restep-eco/Restep/Mother Module/Restep Boost Design Equations.pdf

# Restep Boost Converter Design Calculations www.restep.eco

# Chris Arntzen 1/19/18, edited 12/19/20

# These design calculations and the nomenclature follow the TI LM5022-Q1 Detailed Design

Procedure. Items with orange background are actual selected components and values.

This work is licensed under a Creative Commons Attribution-ShareAlike 4.0 International License.

# Boost Converter Calculations: 48V 120W using LM5022-Q1 Controller____________________

Vin_min≔10.5 | ≔ Vin_max | 25 | ≔ Iout | 2.5 | ≔η | 0.9 | ≔ Vd | 0.5

# Output Voltage Setting_________________________________________________________

Vfb_min≔1.225 | ≔ Vfb_max | 1.275 | ≔ Vdiv_ratio | ――= 1.25
48

0.026

tolR≔0.001 | ≔ TCR | 25 | ≔ Trange | 60
RFB1≔1.3 10 ⋅ | 3 | RFB1_min≔RFB1 ⋅ ⎛

## ⎝1-tolR⎞

⎠-⎛

⎝RFB1 ⋅TCR⋅ 10 ⋅ | = ⁻⁶ Trange⎞
⎠ 1.297 10 ⋅ | 3

RFB1_max≔RFB1 ⋅ ⎛

## ⎝1+tolR⎞

⎠+⎛

⎝RFB1 ⋅TCR⋅ 10 ⋅ | = ⁻⁶ Trange⎞
⎠ 1.303 10 ⋅ | 3
RFB2≔48.7 10 ⋅ | 3 | RFB2_min≔RFB2 ⋅ ⎛ ⎝1-tolR⎞

⎠-⎛

⎝RFB2 ⋅TCR⋅ 10 ⋅ | = ⁻⁶ Trange⎞
⎠ 4.858 10 ⋅ | 4

RFB2_max≔RFB2 ⋅ ⎛

## ⎝1+tolR⎞

⎠+⎛

⎝RFB2 ⋅TCR⋅ 10 ⋅ | = ⁻⁶ Trange⎞
⎠ 4.882 10 ⋅ | 4
Vout_min≔Vfb_min ⋅ | = ⎛
⎜
⎝

――――――― RFB1_max+RFB2_min

RFB1_max

⎞
⎟
⎠

46.887

Vout_max≔Vfb_max ⋅ | = ⎛
⎜
⎝

――――――― RFB1_min+RFB2_max

RFB1_min

⎞
⎟
⎠

49.278

Created with PTC Mathcad Express. See www.mathcad.com for more information.

# Switching Frequency___________________________________________________________

fs_nom ≔400 10 ⋅ | 3 | tolfosc≔.1375 | ≔ RT_calc | ―――――――=

⎛

⎝1 | ⋅ -8 10 ⋅ | -8 fs_nom⎞
⎠
f | ⋅ | ⋅ s_nom 5.77 10⁻¹¹
4.194 10 ⋅ | 4
RT≔42.2 10 ⋅ | 3 | RT_min≔RT ⋅ ⎛ ⎝1-tolR⎞

⎠-⎛

⎝RT ⋅TCR⋅ 10 ⋅ | = ⁻⁶ Trange⎞
⎠ 4.209 10 ⋅ | 4

RT_max≔RT ⋅ ⎛

## ⎝1+tolR⎞

⎠+⎛

⎝RT ⋅TCR⋅ 10 ⋅ | = ⁻⁶ Trange⎞
⎠ 4.231 10 ⋅ | 4
fs_min≔ | = ⎛
⎜
⎝
―――――1 ―――― 8 10 ⋅ | + ⁻⁸ 5.77 10 ⋅ | ⋅ ⁻¹¹ RT_max

⎞
⎟
⎠

⎛

## ⎝1-tolfosc⎞

⎠ 3.421 10 ⋅ | 5
fs_max≔ | = ⎛
⎜
⎝
―――――1 ―――― 8 10 ⋅ | + ⁻⁸ 5.77 10 ⋅ | ⋅ ⁻¹¹ RT_min

⎞
⎟
⎠

⎛

## ⎝1+tolfosc⎞

⎠ 4.534 10 ⋅ 5

# Power and Duty Cycle__________________________________________________________

Pout_min≔Vout_min ⋅ Iout=117.216 | ≔ Pout_max | Vout_max ⋅ Iout=123.195

Pin_min≔―――= Pout_min
η
130.24 | ≔ Pin_max | ―――= Pout_max
η

136.883

Iin_min≔―――= Pin_min

Vin_max

5.21 | ≔ Iin_max | ―――= Pin_max

Vin_min

13.036

## Dmin≔――――――――= ⎛

⎝Vout_min-Vin_max+Vd⎞
⎠

Vout_min+Vd

0.472 | ≔ Dmax | ――――――――= ⎛

⎝Vout_max-Vin_min+Vd⎞
⎠

Vout_max+Vd

0.789

# Inductor and Currents__________________________________________________________

Coilcraft SER2918H-153KL 15uH 10% DCR=2.86mΩ | Isat=21.9A Irms=28A
Lnom ≔15 10 ⋅ | -6 | tolL≔0.1 | ≔ Lmin | Lnom ⋅ ⎛

## ⎝1-tolL⎞

⎠=1.35 10 ⋅ | -5
Isat_rat≔21.9 | ≔ Irms_rat | 28 | ≔ Lmax | Lnom ⋅ ⎛

## ⎝1+tolL⎞

⎠=1.65 10 ⋅ | -5
ΔIL_min≔ | = ⎛
⎜
⎝

――― Vin_min

Lmax

⎞
⎟
⎠

⎛
⎜
⎝

## ――Dmax

fs_max

⎞
⎟
⎠
1.107 | ≔ ΔIL_max | = ⎛
⎜
⎝

――― Vin_max

Lmin

⎞
⎟
⎠

⎛
⎜
⎝

## ――Dmin

fs_min

⎞
⎟
⎠

2.557

ILrms_min≔ | =
Iin_min +² | ⎛
⎜
⎝

## ――― ΔIL_max

12

⎞
⎟
⎠

2
5.214 | ≔ ILrms_max | =
Iin_max +² | ⎛
⎜
⎝

## ――― ΔIL_min

12

⎞
⎟
⎠

2
13.037

ILpk_min≔Iin_min+―――= ΔIL_max

2

6.488 | ILpk_max≔Iin_max+―――= ΔIL_min

2

13.59

ILpk_op≔―――= ILpk_max

Isat_rat

0.621 | ≔ ILrms_op | ―――= ILrms_max

Irms_rat

0.466

## Kmin≔―――= ΔIL_min

ILrms_max

0.085 | ≔ Kmax | ―――= ΔIL_max

ILrms_min

0.49

# Output Capacitor and Output Voltage Ripple________________________________________

# Kemet C1812C335K1RAC7800 3.3uF X7R 1812 100V 10% 20% DC Bias Derating

tolC≔0.1 | ≔ DCbias | 0.2 | ≔ Qty | 3 | ≔ Cnom | 3.3 10 ⋅ | -6

Cout_min≔Qty C⋅ nom ⋅ ⎛

## ⎝1-tolC⎞

⎠ ⋅ ⎛

## ⎝1- DCbias⎞

⎠=7.128 10 ⋅ -6

Cout_max≔Qty C⋅ nom ⋅ ⎛

## ⎝1+tolC⎞

⎠ ⋅ ⎛

## ⎝1- DCbias⎞

⎠=8.712 10 ⋅ -6

ΔVout_max≔―――――= Dmax ⋅ Iout

f | ⋅ s_min Cout_min
0.809 | ≔ ΔVpercent | ――――= ΔVout_max

Vout_max

0.016

# Current Sense Resistor Calculations_______________________________________________

VCL_nom ≔0.5 | ≔ VCL_min | 0.434 | ≔ VCL_max | 0.55 | ≔ ILIM | 20

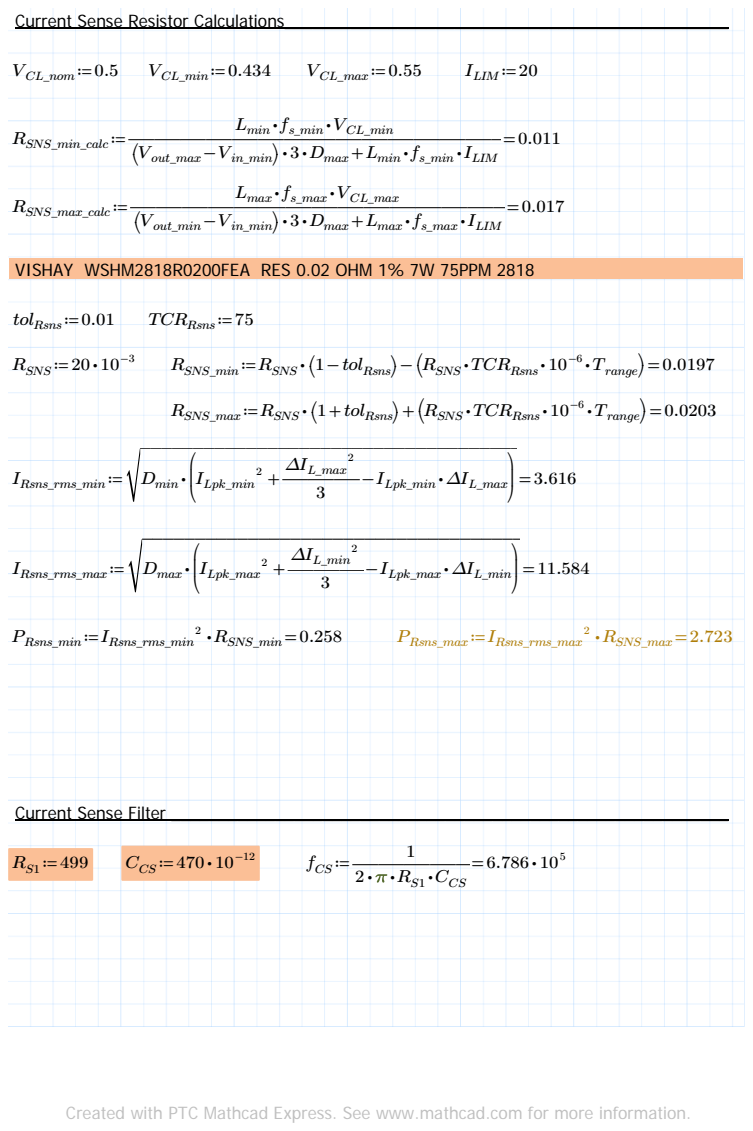
[picture p1: page 4]
RSNS_min_calc≔―――――――――――――――= Lmin ⋅ f; ⋅ s_min VCL_min; ⎝Vout_max-Vin_min⎞; ⎠ ⋅ 3 ⋅ Dmax+Lmin ⋅ f; ⋅ s_min ILIM; RSNS_max_calc≔―――――――――――――――= Lmax ⋅ f; ⋅ s_max VCL_max; ⎝Vout_min-Vin_min⎞; ⎠ ⋅ 3 ⋅ Dmax+Lmax ⋅ f; ⋅ s_max ILIM; tolRsns≔0.01; ≔ TCRRsns; RSNS≔20 10 ⋅; RSNS_min≔RSNS ⋅ ⎛; ⎝1-tolRsns⎞; ⎝RSNS ⋅TCRRsns ⋅ 10 ⋅; = ⁻⁶ Trange⎞; RSNS_max≔RSNS ⋅ ⎛; ⎝1+tolRsns⎞; IRsns_rms_min≔; Dmin ⋅; ILpk_min +; ――― ΔIL_max; ⋅ Lpk_min ΔIL_max; IRsns_rms_max≔; Dmax ⋅; ILpk_max +; ――― ΔIL_min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

VISHAY WSHM2818R0200FEA RES 0.02 OHM 1% 7W 75PPM 2818

Current Sense Filter ___________________________________________________________

# Slope Compensation Resistor_____________________________________________________

RS2_min_calc≔――――――――= VCL_min-I | ⋅ LIM RSNS_min
45 10 ⋅ | ⋅ ⁻⁶ Dmax
1.121 10 ⋅ | 3 | tolRS≔0.001
RS2_max_calc≔――――――――= VCL_max-I | ⋅ LIM RSNS_max
45 10 ⋅ | ⋅ ⁻⁶ Dmin
6.783 10 ⋅ | 3 | TCRRS≔25
RS2≔1.69 10 ⋅ | 3 | RS2_min≔RS2 ⋅ ⎛ ⎝1-tolRS⎞

⎠-⎛

⎝RS2 ⋅TCRRS ⋅ 10 ⋅ | = ⁻⁶ Trange⎞
⎠ 1.6858 10 ⋅ | 3

RS2_max≔RS2 ⋅ ⎛

## ⎝1+tolRS⎞

⎠+⎛

⎝RS2 ⋅TCRRS ⋅ 10 ⋅ | = ⁻⁶ Trange⎞
⎠ 1.6942 10 ⋅ | 3

RS1_min≔RS1 ⋅ ⎛

## ⎝1-tolRS⎞

⎠-⎛

⎝RS1 ⋅TCRRS ⋅ 10 ⋅ | = ⁻⁶ Trange⎞
⎠ 497.753

RS1_max≔RS1 ⋅ ⎛

## ⎝1+tolRS⎞

⎠+⎛

⎝RS1 ⋅TCRRS ⋅ 10 ⋅ | = ⁻⁶ Trange⎞
⎠ 500.248

# Current Limit Trip Point_________________________________________________________

ITRIP_min≔――――――――――――――――= VCL_min-45 10 ⋅ | ⋅ | ⋅ ⁻⁶ Dmax ⎛ ⎝RS2_max+RS1_max+2000⎞
⎠
| | RSNS_max

14.049

ITRIP_max≔――――――――――――――――= VCL_max-45 10 ⋅ | ⋅ | ⋅ ⁻⁶ Dmin ⎛ ⎝RS2_min+RS1_min+2000⎞
⎠
| | RSNS_min

23.392

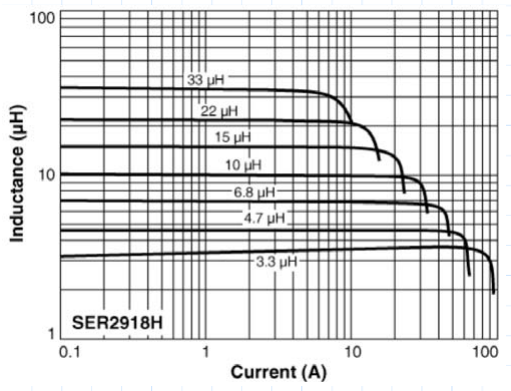
[picture p2: figure]

# Slope Compensation Comparison_________________________________________________

Sn_min≔――――――= R | ⋅ SNS_min Vin_min

Lmax

1.254 10 ⋅ | 4 | Sn_max≔――――――= R | ⋅ SNS_max Vin_max
| | | Lmin
3.757 10 ⋅ | 4
Se_min≔45 10 ⋅ | ⋅ | ⋅ | = ⁻⁶ fs_min ⎛
⎝RS1_min+RS2_min+2000⎞
⎠ 6.441 10 ⋅ | 4
Se_max≔45 10 ⋅ | ⋅ | ⋅ | = ⁻⁶ fs_max ⎛
⎝RS1_max+RS2_max+2000⎞

⎠ 8.558 10 ⋅ 4

# Want slope compensation ramp ratio of 1, or at least 0.5 (Se/Sn)

SCratio_min≔―――= Se_min

Sn_max

1.714 | ≔ SCratio_max | ―――= Se_max

Sn_min

6.823

# Loss Calculations______________________________________________________________

# VISHAY SQJA92EP-T1_GE3 MOSFET

RDS_ON_max≔0.0095 1.3 0.012 | ≔ ⋅ | = | tr | 10 10 ⋅ | -9 | tf≔25 10 ⋅ | -9 | Qg≔45 10 ⋅ | -9
ICC≔0.004 | ≔ IGC | Qg ⋅ fs_max=0.02 | PQ_max≔Vin_max ⋅ ⎛

⎝ICC +IGC⎞
⎠=0.61

PSW_max≔0.5 ⋅Vin_min ⋅ Iin_max ⋅ ⎛

## ⎝tr+tf

⎞

## ⎠ ⋅ fs_max=1.086

PCOND_max≔Dmax ⋅ Iin_max ⋅ | = ² RDS_ON_max | 1.656

PFET_max≔PSW_max+PCOND_max=2.742

NOTE: the FET selected above failed during testing at full load and low line, likely due to operation outside of the FET SOA. The FET below is the chosen replacement and did not fail during testing.

# VISHAY SUM70060E MOSFET

RDS_ON_max≔0.0062 1.3 0.008 | ≔ ⋅ | = | tr | 44 10 ⋅ | -9 | tf≔18 10 ⋅ | -9 | Qg≔81 10 ⋅ | -9
ICC≔0.004 | ≔ IGC | Qg ⋅ fs_max=0.037 | PQ_max≔Vin_max ⋅ ⎛

⎝ICC +IGC⎞
⎠=1.018

PSW_max≔0.5 ⋅Vin_min ⋅ Iin_max ⋅ ⎛

## ⎝tr+tf

⎞

## ⎠ ⋅ fs_max=1.924

PCOND_max≔Dmax ⋅ Iin_max ⋅ | = ² RDS_ON_max | 1.081

PFET_max≔PSW_max+PCOND_max=3.005

# Diodes Inc. SDT5H100P5-7 Schottky Rectifier

## PD_max≔Vd ⋅ Iout=1.25

# Inductor losses estimated by Coilcraft online loss calculator @ 50degC, max Iin & fs

PL_max≔0.554 | Almost all loss is due to winding DCR

PLOSS_max≔PL_max+PD_max+PFET_max+PQ_max+PRsns_max=8.549

ηest≔―――――――= Pout_max

Pout_max+PLOSS_max

0.935

# Under Voltage Lock Out_________________________________________________________

VSD_min≔1.22 | ≔ VSD_max | 1.28 | ≔ tolRuv | 0.01 | ≔ TCRRuv | 100
RUVbot≔1.47 10 ⋅ | 3 | RUVtop≔10 10 ⋅ | 3

RUVbot_min≔RUVbot⋅ ⎛

## ⎝1-tolRuv⎞

⎠-⎛

⎝RUVbot⋅TCRRuv ⋅ 10 ⋅ | = ⁻⁶ Trange⎞
⎠ 1.446 10 ⋅ | 3

RUVbot_max≔RUVbot⋅ ⎛

## ⎝1+tolRuv⎞

⎠+⎛

⎝RUVbot⋅TCRRuv ⋅ 10 ⋅ | = ⁻⁶ Trange⎞
⎠ 1.494 10 ⋅ | 3

RUVtop_min≔RUVtop ⋅ ⎛

## ⎝1-tolRuv⎞

⎠-⎛

⎝RUVtop ⋅TCRRuv ⋅ 10 ⋅ | = ⁻⁶ Trange⎞
⎠ 9.84 10 ⋅ | 3

RUVtop_max≔RUVtop ⋅ ⎛

## ⎝1+tolRuv⎞

⎠+⎛

⎝RUVtop ⋅TCRRuv ⋅ 10 ⋅ | = ⁻⁶ Trange⎞
⎠ 1.016 10 ⋅ | 4
VUVLO_min≔VSD_min ⋅ | = ⎛
⎜
⎝

―――――――― RUVbot_max+RUVtop_min

RUVbot_max

⎞
⎟
⎠

9.258

VUVLO_max≔VSD_max ⋅ | = ⎛
⎜
⎝

―――――――― RUVbot_min+RUVtop_max

RUVbot_min

⎞
⎟
⎠

10.271

# Soft Start____________________________________________________________________

ISS_min≔7 10 ⋅ | -6 | ISS_max≔13 10 ⋅ | -6 | VSS_OFF_min≔0.344 | ≔ VSS_OFF_max | 0.75
CSS≔100 10 ⋅ | -9
CSS_min≔CSS ⋅ 0.9 0.85 | ⋅ ⋅ | =7.65 10⁻⁸
CSS_max≔CSS ⋅ 1.1 1.15 | ⋅ ⋅ | =1.265 10⁻⁷
tSS_min≔―――――――= V | | ⋅ SS_OFF_min CSS_min

ISS_max

0.002 | ≔ tSS_max | ―――――――= V | ⋅ SS_OFF_max CSS_max

ISS_min

0.014
