restep-eco/Restep/Restep Color Code Rev.B.pdf

## Restep Power System LED Color Code (Rev. B)

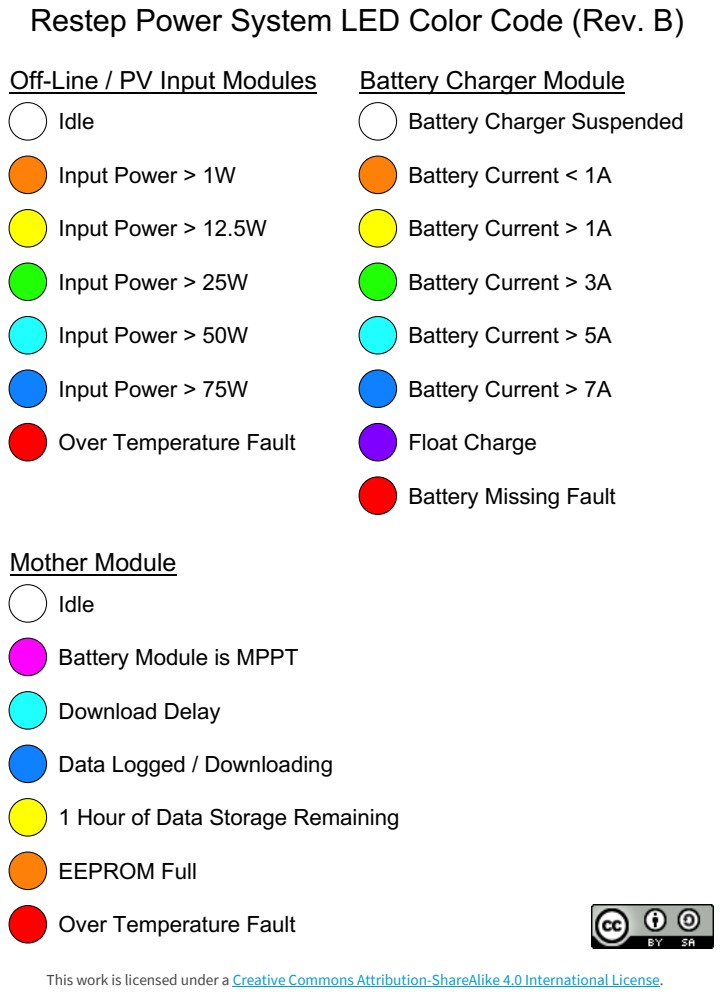
[picture p3: page 1]
Off-Line / PV Input Modules; Battery Charger Module; Idle; Battery Charger Suspended; Input Power > 1W; Battery Current < 1A; Input Power > 12.5W; Battery Current > 1A; Input Power > 25W; Battery Current > 3A; Input Power > 50W; Battery Current > 5A; Input Power > 75W; Battery Current > 7A; Over Temperature Fault; Float Charge; Mother Module; Download Delay; EEPROM Full

Battery Missing Fault

Battery Module is MPPT

Data Logged / Downloading

1 Hour of Data Storage Remaining

Over Temperature Fault

This work is licensed under a Creative Commons Attribution-ShareAlike 4.0 International License.
