restep-eco/Restep/Restep Block Diagram.pdf

# Restep Power System Simplified Block Diagram

This work is licensed under a Creative Commons Attribution-ShareAlike 4.0 International License. (https://creativecommons.org/licenses/by-sa/4.0/)

7/1/21 | www.restep.eco

# Current Architecture

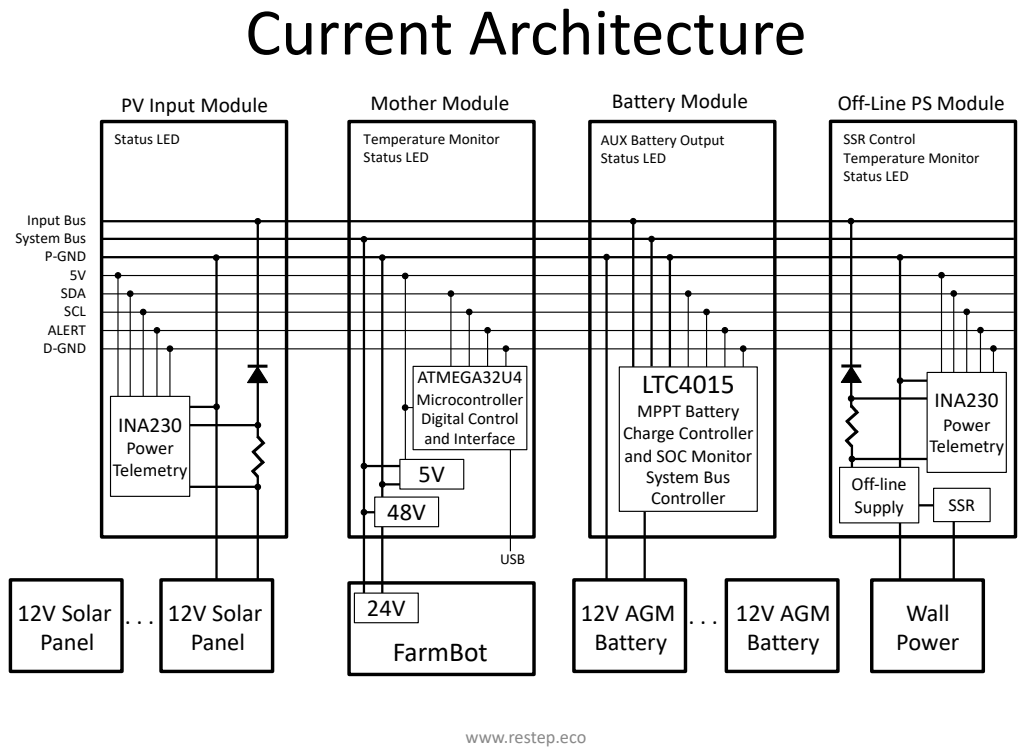
[picture p4: page 2]
Input Bus System Bus P-GND 5V SDA SCL ALERT D-GND; 12V Solar; Panel; FarmBot; USB; Status LED; Temperature Monitor; ATMEGA32U4 Microcontroller Digital Control and Interface; 12V Solar Panel; 12V AGM; Battery; 12V AGM Battery; SSR Control Temperature Monitor Status LED; Off-line Supply; Wall Power; SSR; INA230 Power Telemetry; PV Input Module; Mother Module; Battery Module; Off-Line PS Module

AUX Battery Output
Status LED

LTC4015
MPPT Battery
Charge Controller
and SOC Monitor
System Bus
Controller

www.restep.eco

# Architecture with UIM

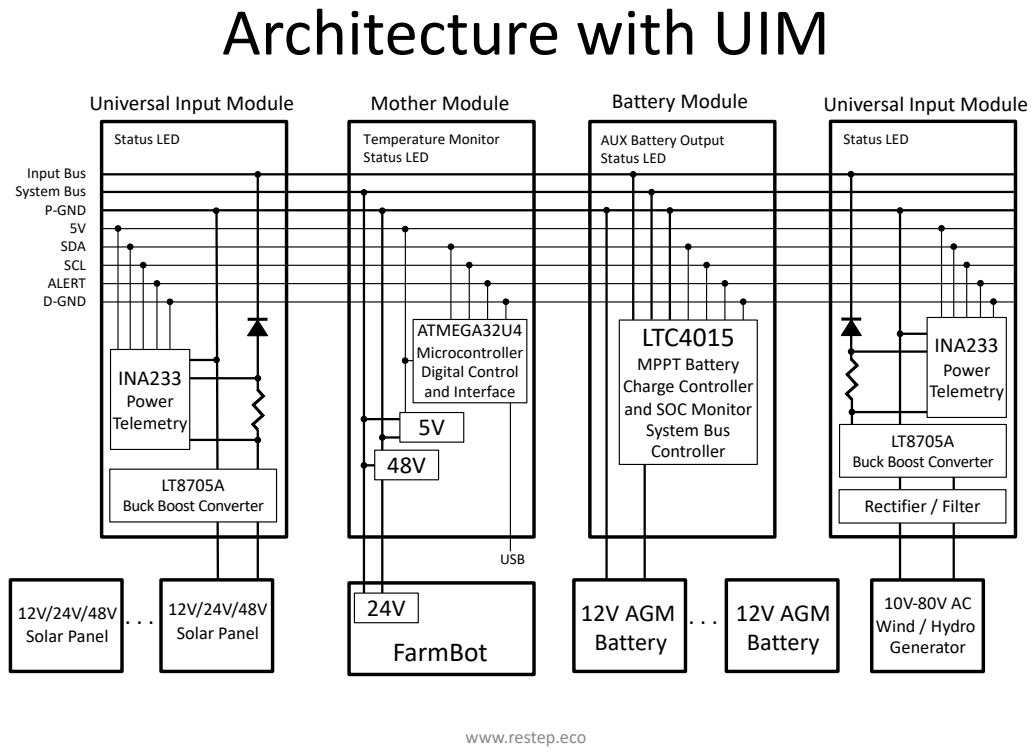
[picture p5: page 3]
Input Bus System Bus P-GND 5V SDA SCL ALERT D-GND; 12V/24V/48V Solar Panel; Status LED; Temperature Monitor; 12V AGM; Battery; 10V-80V AC Wind / Hydro Generator; INA233 Power Telemetry; Universal Input Module; Mother Module; Battery Module; Rectifier / Filter; 12V AGM Battery; USB; 24V FarmBot; ATMEGA32U4 Microcontroller Digital Control and Interface

Universal Input Module

AUX Battery Output
Status LED

LTC4015
MPPT Battery
Charge Controller
and SOC Monitor
System Bus
Controller

Buck Boost Converter

www.restep.eco
