restep-eco/Restep/Mother Module/RESTEP MOTHER MODULE SCHEMATIC.pdf

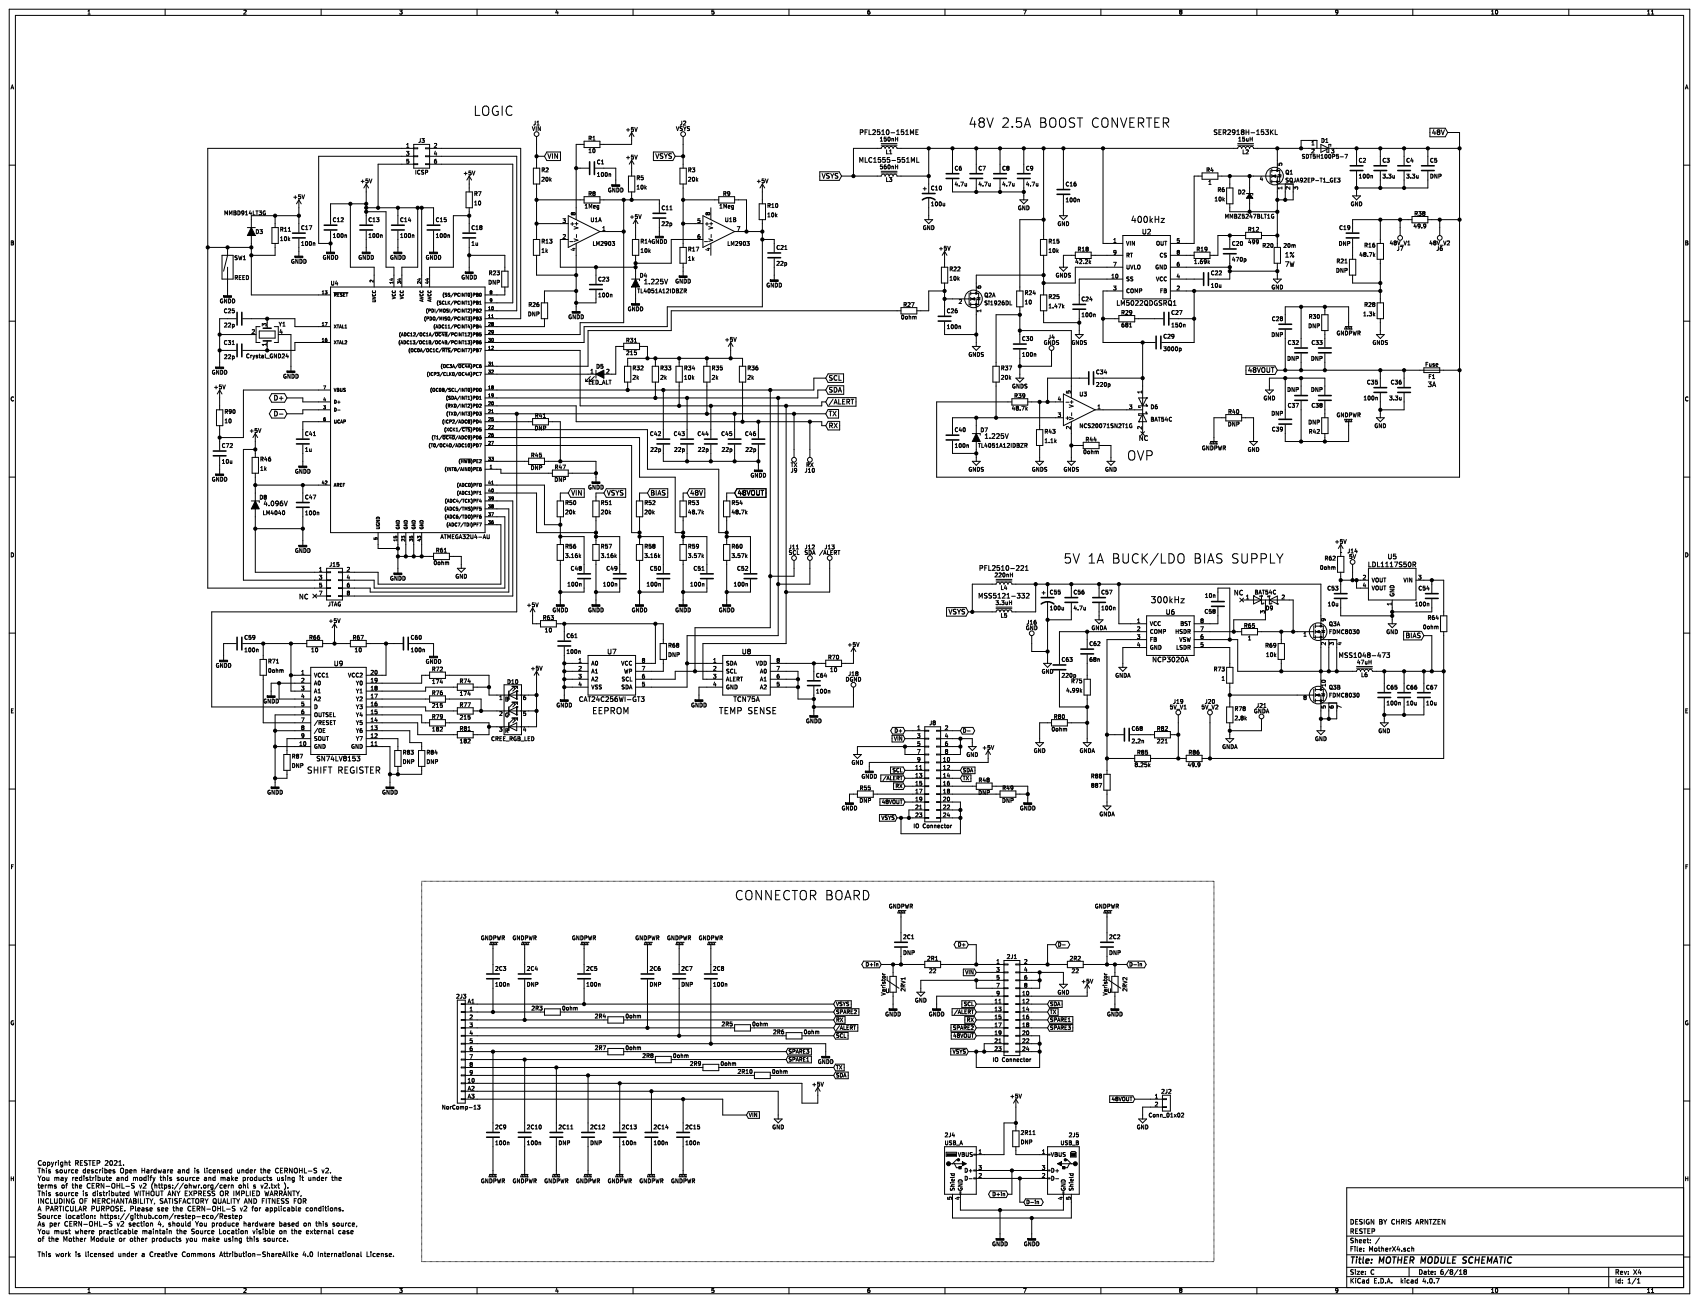
[picture p6: page 1]
