restep-eco/Restep/Off-Line Module/RESTEP OFF-LINE PV MODULE SCHEMATIC.pdf

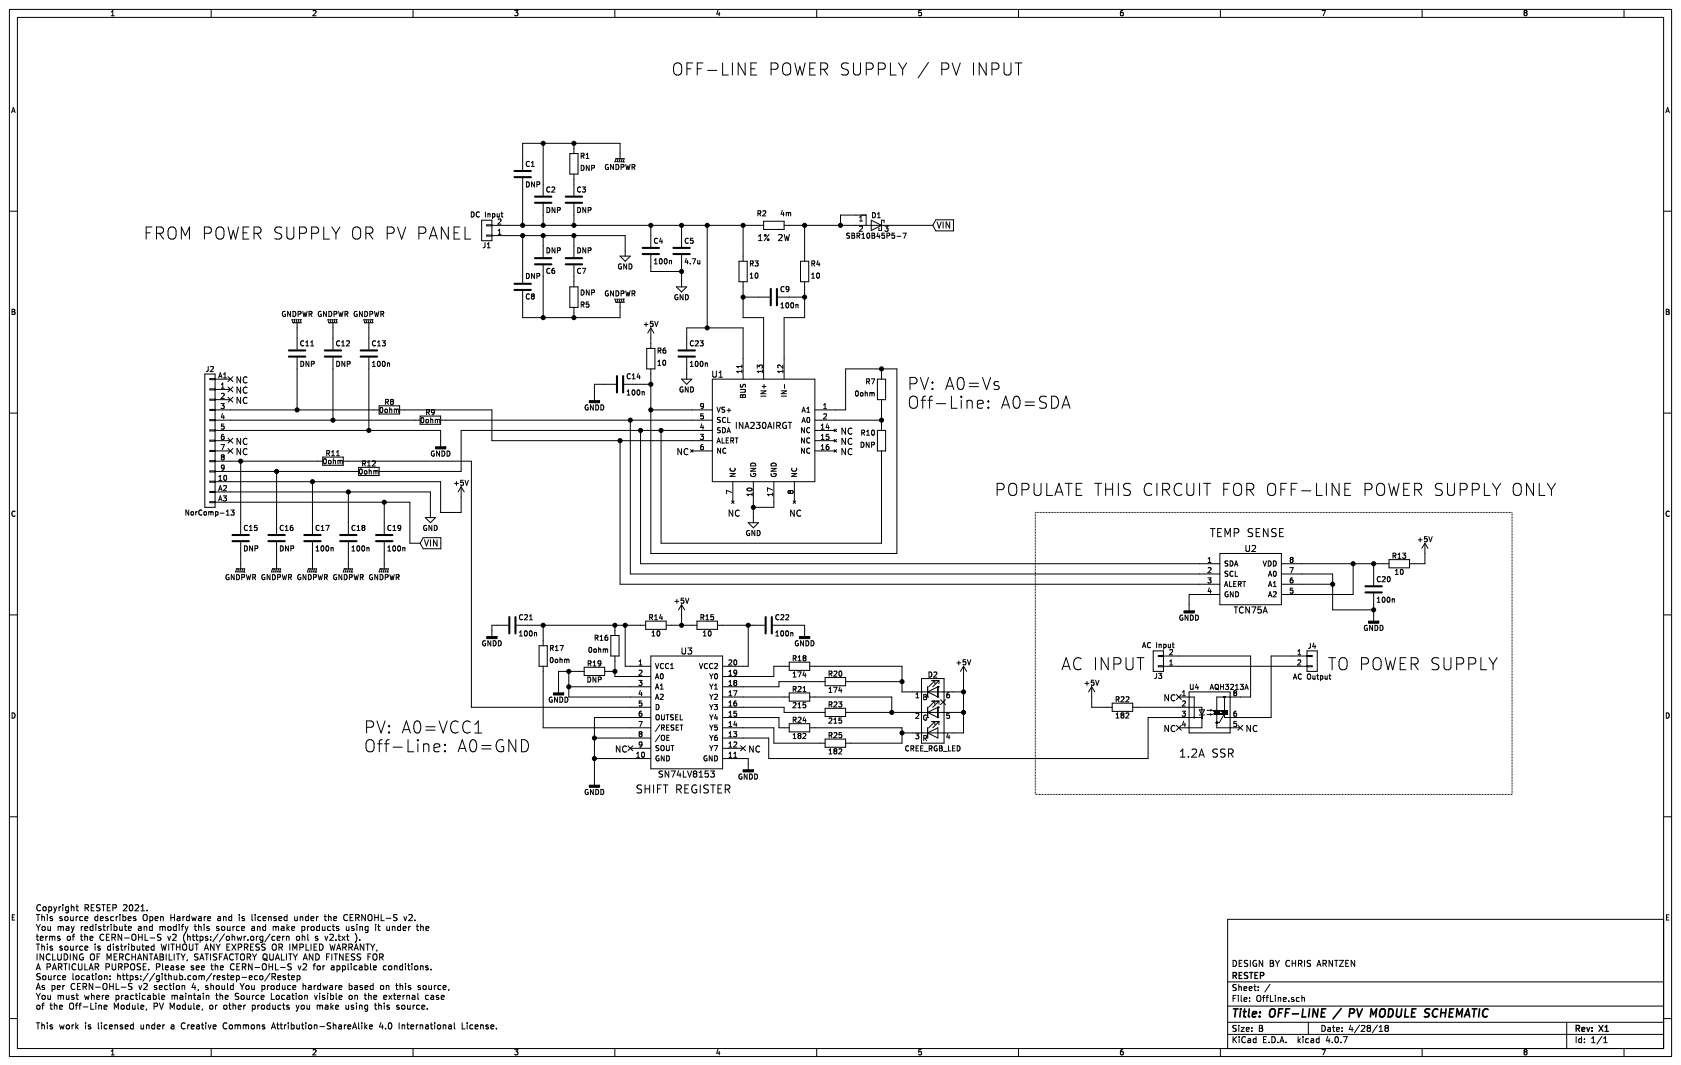
[picture p7: page 1]
