restep-eco/Restep/Battery Charger Module/RESTEP BATTERY CHARGER MODULE SCHEMATIC.pdf

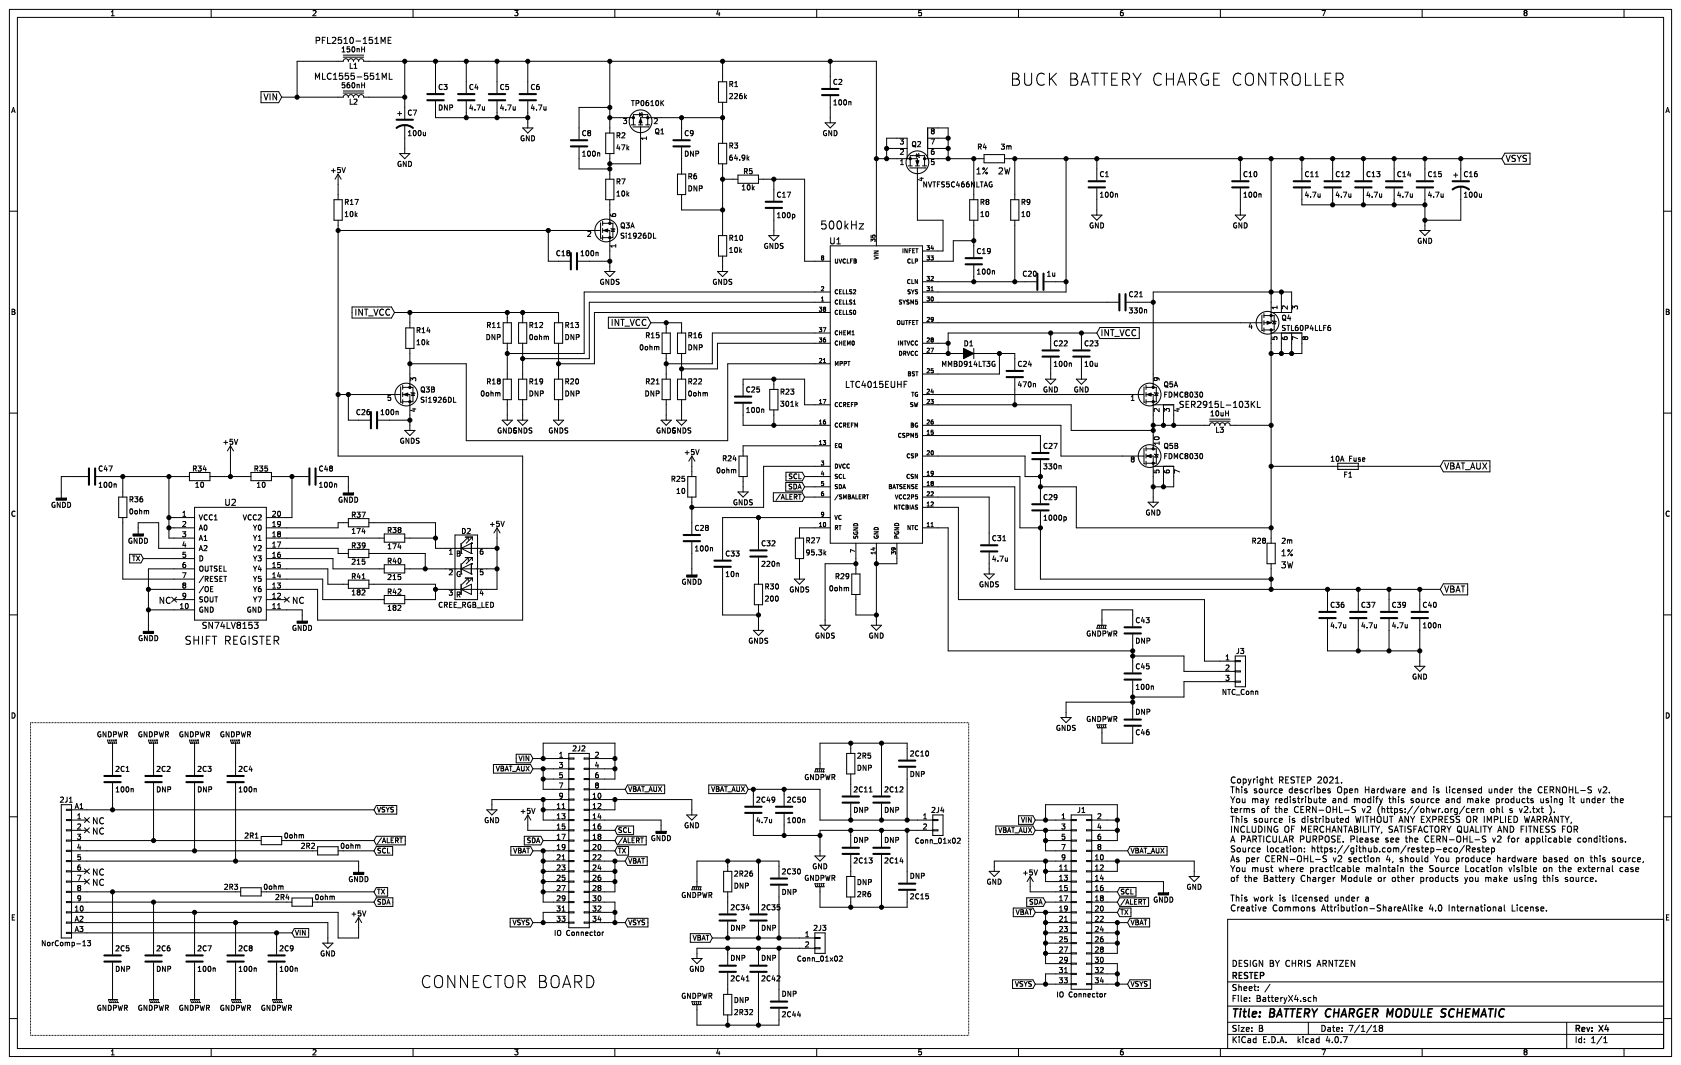
[picture p8: page 1]
