restep-eco/Restep/Battery Charger Module/RESTEP BATTERY CHARGER MODULE PCB.pdf

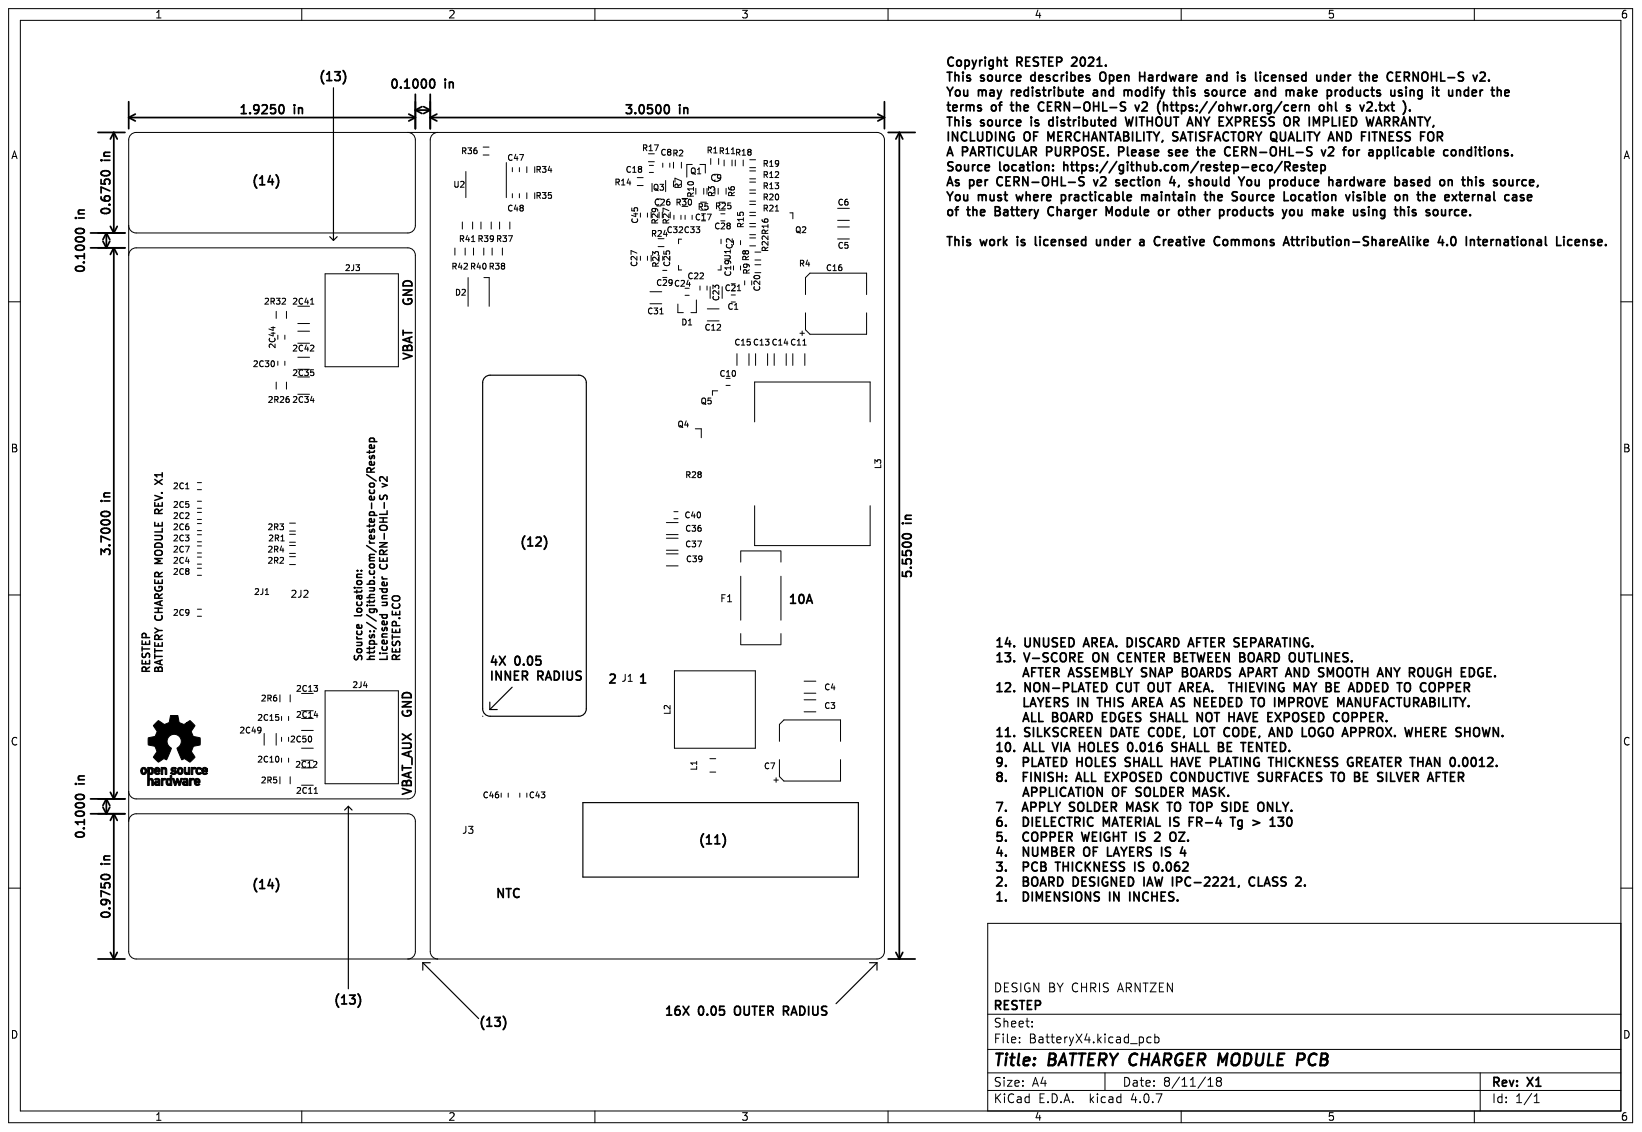
[picture p9: page 1]
