restep-eco/Restep/Mother Module/RESTEP MOTHER MODULE PCB.pdf

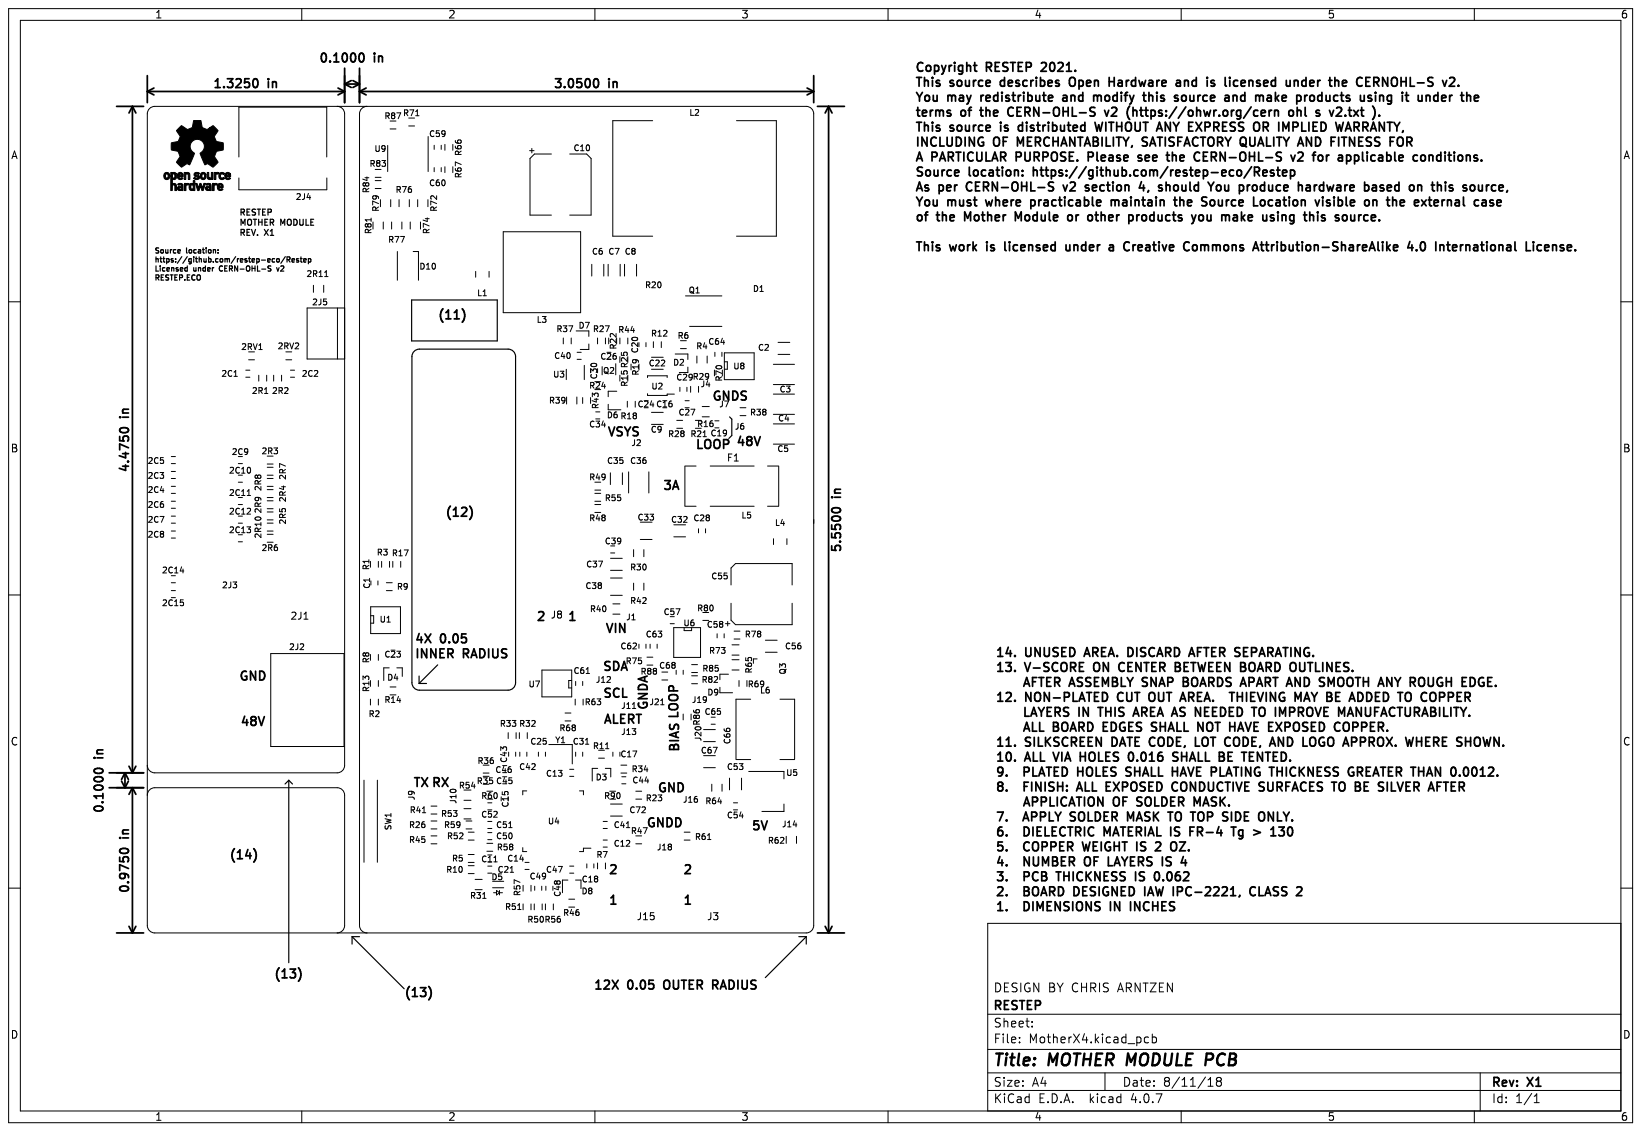
[picture p10: page 1]
