restep-eco/Restep/Off-Line Module/RESTEP OFF-LINE PV MODULE PCB.pdf

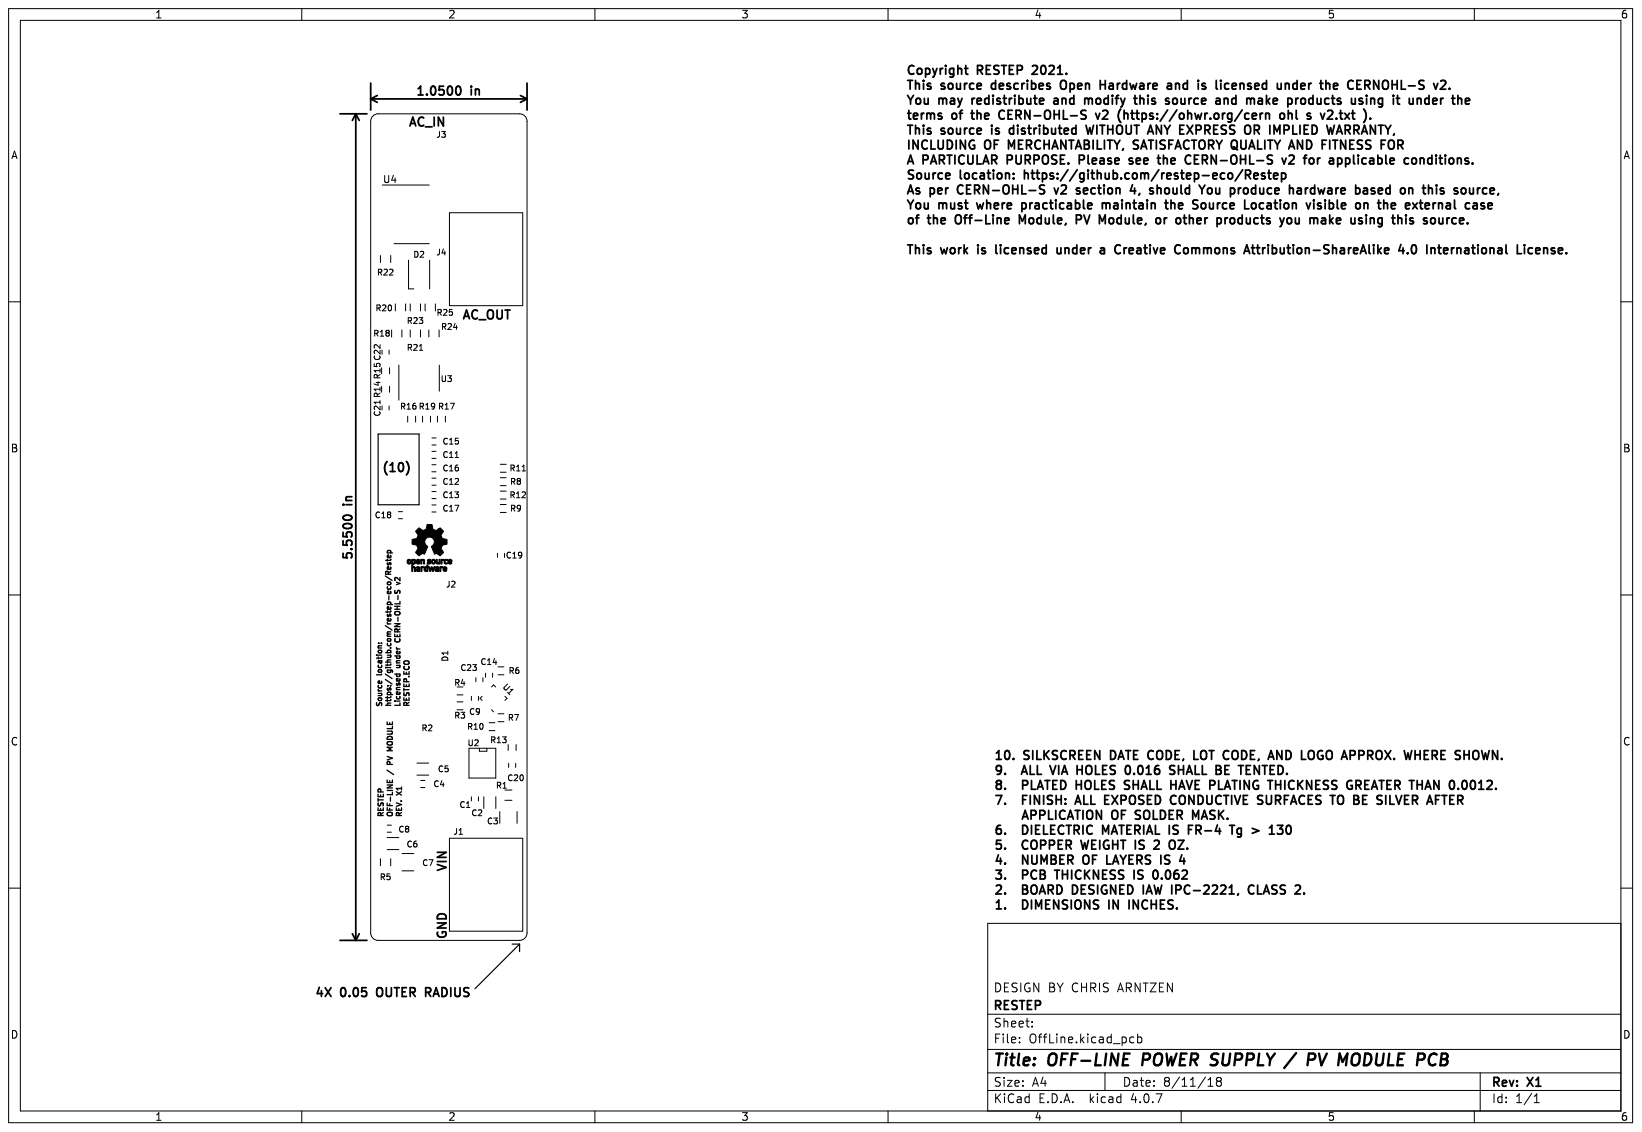
[picture p11: page 1]
