restep-eco/Restep/Battery Charger Module/RESTEP-BoostAndBattery-EMIfilter-Freq.asc

C1: cap; 80µ
C2: cap; 3µ; x3
C3: cap; 120µ
C4: cap; 3µ; x3
L1: ind; 180n
L2: ind; 440n
L3: ind; 120n
L4: ind; 440n
R1: res; 27m
R2: res; 1.48m
R3: res; 14m
R4: res; 27m
R5: res; 1.48m
R6: res; 56m
V1: voltage; ""; AC 1
V2: voltage; ""; AC 1
Named nets: out1, 0, out2
MLC1555-551ML
550nH 20%
Series R=1.48mOhm
Isat=35.7A, Irms=22.3A
PFL2510-151ME
150nH 20%
Series R=27-36mOhm
Isat=4.1A, Irms=2.9A
50PEV100M10X10.5
100uF 20% ESR=28mOhm
Ripple Current rating = 2000mA
C1206C475K5PACTU
4.7uF, 3uF after 24V DC bias
.ac dec 100 100 1Meg
Restep Mother Module 48V Boost Converter & Battery Charger Module EMI Filter 
Frequency Response Model
Worst-Case Peaking
Worst-Case Attenuation
Copyright (c) 2021, RESTEP
 
Permission is hereby granted, free of charge, to any person obtaining a copy
of this software and associated documentation files (the "Software"), to deal
in the Software without restriction, including without limitation the rights
to use, copy, modify, merge, publish, distribute, sublicense, and/or sell
copies of the Software, and to permit persons to whom the Software is
furnished to do so, subject to the following conditions:
 
The above copyright notice and this permission notice shall be included in all
copies or substantial portions of the Software.
 
THE SOFTWARE IS PROVIDED "AS IS", WITHOUT WARRANTY OF ANY KIND, EXPRESS OR
IMPLIED, INCLUDING BUT NOT LIMITED TO THE WARRANTIES OF MERCHANTABILITY,
FITNESS FOR A PARTICULAR PURPOSE AND NONINFRINGEMENT. IN NO EVENT SHALL THE
AUTHORS OR COPYRIGHT HOLDERS BE LIABLE FOR ANY CLAIM, DAMAGES OR OTHER
LIABILITY, WHETHER IN AN ACTION OF CONTRACT, TORT OR OTHERWISE, ARISING FROM,
OUT OF OR IN CONNECTION WITH THE SOFTWARE OR THE USE OR OTHER DEALINGS IN THE
SOFTWARE.
