restep-eco/Restep/Mother Module/RESTEP-BiasSupply-EMIfilter-Freq.asc

C1: cap; 80µ
C2: cap; 3µ
C3: cap; 120µ
C4: cap; 3µ
L1: ind; 264n
L2: ind; 2.64µ
L3: ind; 176n
L4: ind; 2.64µ
R1: res; 37m
R2: res; 70m
R3: res; 14m
R4: res; 37m
R5: res; 70m
R6: res; 56m
V1: voltage; ""; AC 1
V2: voltage; ""; AC 1
Named nets: out1, 0, out2
MSS5121-332
3.3uH 20%
Series R=70mOhm
Isat=2A, Irms=2.3A
PFL2510-221
220nH 20%
Series R=37-47mOhm
Isat=3.4A, Irms=2.5A
50PEV100M10X10.5
100uF 20% ESR=28mOhm
Ripple Current rating = 2000mA
C1206C475K5PACTU
4.7uF, 3uF after 24V DC bias
.ac dec 100 100 1Meg
Worst-Case Peaking
Worst-Case Attenuation
Restep Mother Module Bias Supply EMI Filter Frequency Response Model
Copyright (c) 2021, RESTEP
 
Permission is hereby granted, free of charge, to any person obtaining a copy
of this software and associated documentation files (the "Software"), to deal
in the Software without restriction, including without limitation the rights
to use, copy, modify, merge, publish, distribute, sublicense, and/or sell
copies of the Software, and to permit persons to whom the Software is
furnished to do so, subject to the following conditions:
 
The above copyright notice and this permission notice shall be included in all
copies or substantial portions of the Software.
 
THE SOFTWARE IS PROVIDED "AS IS", WITHOUT WARRANTY OF ANY KIND, EXPRESS OR
IMPLIED, INCLUDING BUT NOT LIMITED TO THE WARRANTIES OF MERCHANTABILITY,
FITNESS FOR A PARTICULAR PURPOSE AND NONINFRINGEMENT. IN NO EVENT SHALL THE
AUTHORS OR COPYRIGHT HOLDERS BE LIABLE FOR ANY CLAIM, DAMAGES OR OTHER
LIABILITY, WHETHER IN AN ACTION OF CONTRACT, TORT OR OTHERWISE, ARISING FROM,
OUT OF OR IN CONNECTION WITH THE SOFTWARE OR THE USE OR OTHER DEALINGS IN THE
SOFTWARE.
