restep-eco/Restep/Mother Module/RESTEP-LM5022Q1-48Vboost.asc

A1: srflop
A2: or
B1: bv; V={if(V(ramp)>V(EAout),1.5,0)}
B2: bv; V={if(V(ramp)>0.5,1.5,0)}
B3: bi; P=table(time,0,60,5.9m,60,6m,120)
B4: bv; V=table(time,0,24,4m,24,4.5m,10.5,5m,10.5)
C1: cap; 470p
C2: cap; 150n
C3: cap; 3n
C4: cap; 100n
C5: cap; 3.3µ; x2
C7: cap; 100n
C8: cap; 4.7µ; x3
C9: cap; 100µ; Rser=28m
D1: schottky; PDS5100
I1: current; PULSE(0 45u 0 2.498u 1n 1n 2.5u)
I2: current; PWL(0 50u 2.5m 0)
L1: ind; 15µ; Rser=2.6m
L2: ind; 560n; Rser=1.34m
L3: ind; 150n; Rser=27m
M1: nmos; SUM70060E
Q1: npn; 2N3904
R1: res; 5k
R2: res; 48.7k
R3: res; 2k
R4: res; 499
R5: res; 1.69k
R6: res; 20m
R7: res; 681
R8: res; 1
R9: res; 10k
R10: res; 100k
R11: res; 50k
R12: res; 1.3k
R13: res; 1k
S1: sw; MYSW
S2: sw; MYSW2
U1: OP292
U3: LTC1693-3
V1: voltage; PULSE(0 1.5 0 1n 1n 30n 2.5u)
V2: voltage; 1.4
V3: voltage; 1.25
V6: voltage; 7
V7: voltage; PULSE(0 1.5 2.374u 1n 1n 0.124u 2.5u)
V8: voltage; PULSE(0 1 0 1n 1n 65n 2.5u)
V9: voltage; 5
Named nets: 0, 5V, out, 7V, gate, ref, Dmax, PWM, EAout, ramp, LEB, clk, oc, D, S, G, in, emi
.include SUM70060E_PS_Rev_A.lib
.tran 8m
.model MYSW SW(Ron=10Meg Roff=1m Vt=.5 Vh=-.4)
.model MYSW SW(Ron=10Meg Roff=1m Vt=.5 Vh=-.4)
.model MYSW2 SW(Ron=40 Roff=10Meg Vt=.5 Vh=-.4)
LM5022Q1 Model
Restep Power System 48V 120W Boost Converter
NOTE:
This model is not 100% accurate, but is a "ball-park" simulation
It works best starting up with 24V in and with at least a 3W load
Copyright (c) 2021, RESTEP
 
Permission is hereby granted, free of charge, to any person obtaining a copy
of this software and associated documentation files (the "Software"), to deal
in the Software without restriction, including without limitation the rights
to use, copy, modify, merge, publish, distribute, sublicense, and/or sell
copies of the Software, and to permit persons to whom the Software is
furnished to do so, subject to the following conditions:
 
The above copyright notice and this permission notice shall be included in all
copies or substantial portions of the Software.
 
THE SOFTWARE IS PROVIDED "AS IS", WITHOUT WARRANTY OF ANY KIND, EXPRESS OR
IMPLIED, INCLUDING BUT NOT LIMITED TO THE WARRANTIES OF MERCHANTABILITY,
FITNESS FOR A PARTICULAR PURPOSE AND NONINFRINGEMENT. IN NO EVENT SHALL THE
AUTHORS OR COPYRIGHT HOLDERS BE LIABLE FOR ANY CLAIM, DAMAGES OR OTHER
LIABILITY, WHETHER IN AN ACTION OF CONTRACT, TORT OR OTHERWISE, ARISING FROM,
OUT OF OR IN CONNECTION WITH THE SOFTWARE OR THE USE OR OTHER DEALINGS IN THE
SOFTWARE.
