restep-eco/Restep/(commit log)

2020-10-21 Add files via upload
    Version xC 2/28/20
    This firmware works in conjunction with the PLX-DAQ
    Rev A: RGB LEDs, Temp Sensors, AGM Battery Charging, EEPROM, Over Temp ALERT and protection
    Rev B adds: EEPROM full warning and overrun protection, forces LTC4015 measurement system on when Vin is absent, Q_COUNT, BSR
    Rev C: fixes the mother module light logic, adds hibernate function
2021-05-12 Added Mother Module Schematic
2021-05-12 Added Schematics
2021-07-01 Added Boost Converter LTSpice model and FET .lib
2021-07-02 Added EMI Filter models and Block Diagram
2021-07-13 Update RESTEP BATTERY CHARGER MODULE SCHEMATIC.pdf
    Updated schematic
2021-07-13 Updated schematics
2021-07-13 Added Battery Charger Module source files
    Initial release
2021-07-13 Added Mother Module source files
    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
    [PLX-DAQ Data File.xlsm, Restep AddressMap.xlsx, Restep BoostComp48V.xlsx]
2021-07-13 Create Restep Sample_Data_3-7-20.xlsm
    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
    [Restep Sample_Data_3-7-20.xlsm]
2021-07-16 Reduced PCB PDFs to a single page
    PCB PDFs were previously quadruplicated
2021-07-16 Updated Off-Line Module BOM
    Added the Off-Line power supply
